lrklochek/Control_System/images/Schematic2.jpg

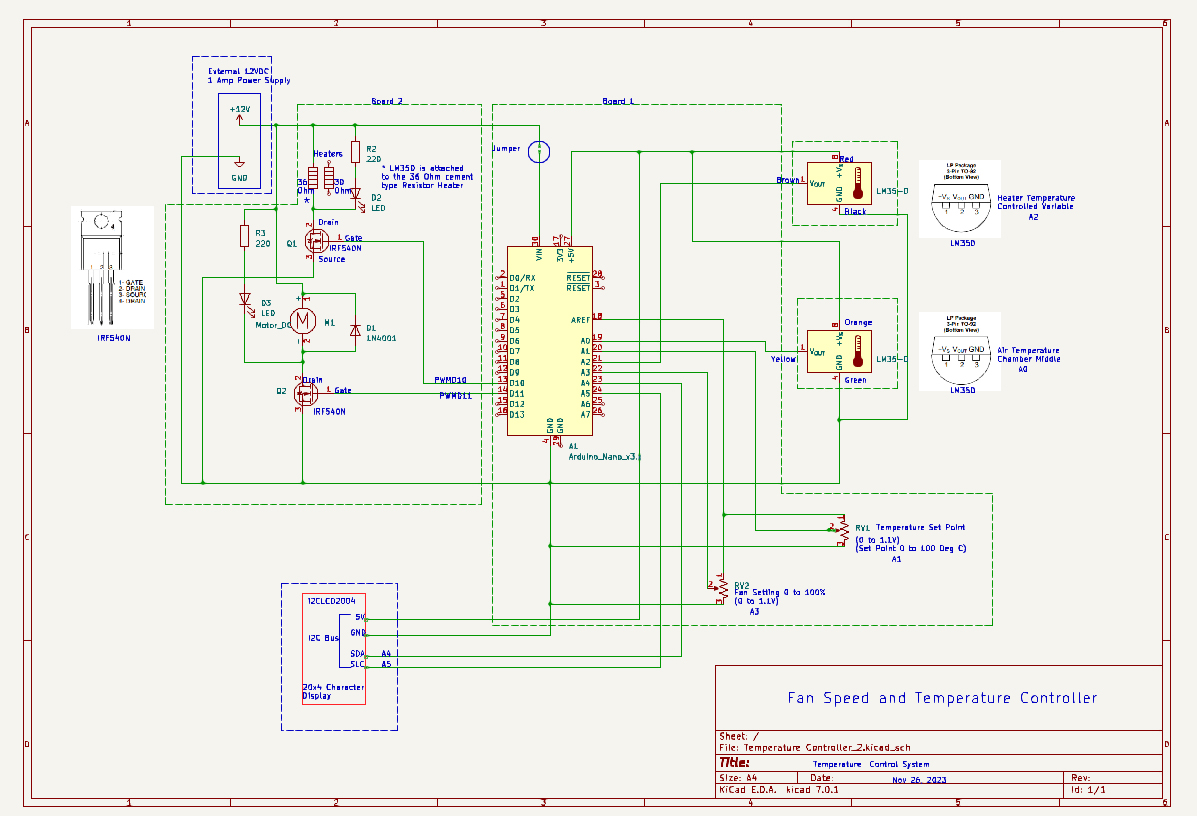
images/Schematic2.jpg
